apostkap/Arduina/photos/15.jpg

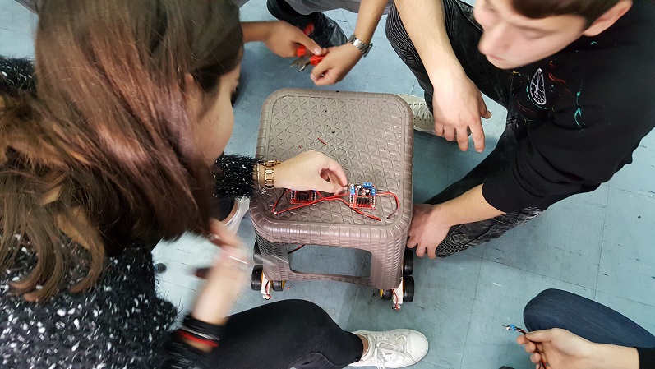
photos/15.jpg
