apostkap/Arduina/photos/26.jpg

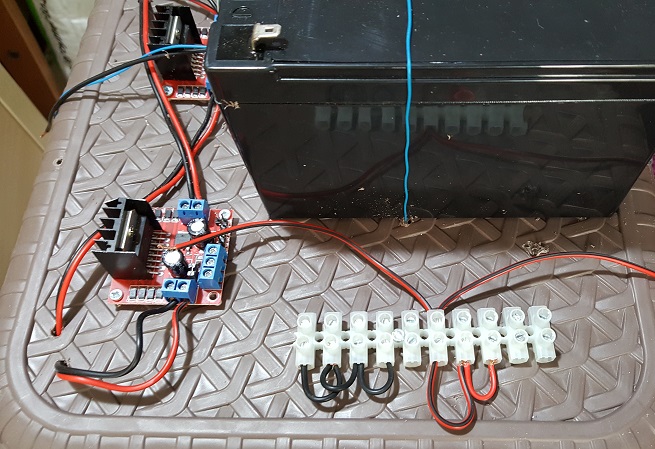
photos/26.jpg
