apostkap/Arduina/README.md

# Arduina- 1ο ΕΠΑΛ Ελευθερούπολης

Έργο για τον Διαγωνισμό Ρομποτικής

«Δεν θέλουμε να δούμε τον πλανήτη μας να μετασχηματίζεται σε μια απέραντη χωματερή. Επιδιώκουμε μείωση του όγκου των σκουπιδιών μας» 

«Επαναχρησιμοποίηση των πάντων, τις περισσότερες φορές μέσω μεταποίησης των αρχικών προϊόντων»

«Όταν η κίνηση οποιουδήποτε οχήματος είναι συνυφασμένη με καύση υδρογονανθράκων η κλιματική αλλαγή είναι αναπόφευκτη. Αλλάζουμε αντιλήψεις, τα οχήματα μας δεν εκπέμπουν καυσαέρια»

«Χρησιμοποιούμε ανοικτό κώδικα και ανοικτό hardware, πιστεύουμε στην επαναχρησιμοποίηση λογισμικού και υλικού, σε φθηνές λύσεις δηλαδή κατασκευής και προγραμματισμού εξαρτημάτων-συσκευών»

«Κατανοούμε τις συνέπειες της κλιματικής αλλαγής, μαθαίνουμε τις αιτίες δημιουργίας της και αλλάζουμε αντιλήψεις και πρακτικές»

Τις παραπάνω σκέψεις ενσωματώσαμε στην ιδέα μας για την κατασκευή του ανθρωπόμορφου ρομπότ μας. Θέλουμε να κατασκευάσουμε ένα σχετικά μεγάλο ρομπότ, μεγαλύτερο από τις συνηθισμένες διαστάσεις των οχημάτων που προγραμματίζονται με arduino. Επίσης ως προς την κατασκευή δεν θέλουμε να μείνουμε στο απλό κούμπωμα- βίδωμα συμβατικών εξαρτημάτων αλλά στον αυτοσχεδιασμό και στην εφευρετικότητα. Και το σημαντικότερο η κατασκευή μας θέλουμε να έχει χαμηλό κόστος και επαναχρησιμοποιούμενα υλικά.
Το κορμί της Arduina (το όνομα του ρομπότ μας) θα «χτιστεί» με δύο επαναχρησιμοποιούμενα σκαμπό ντυμένα με μακό T-shirt. Το κεφάλι θα κατασκευαστεί από σκληρό χαρτόνι (σχεδίαση με γεωμετρικά όργανα, κόψιμο με ψαλίδι και κόλλημα με κόλλες stick). Οι άξονες από ρόδες-κινητήρες θα στερεωθούν πάνω σε ηλεκτρολογικό κανάλι.
Το κεφάλι της  Arduina θα μπορεί να περιστρέφεται δεξιά και αριστερά όταν κάποιος το πλησιάζει. Στην θέση των ματιών θα υπάρχουν LCD οθόνες όπου θα εμφανίζονται διάφορα μηνύματα, σχήματα και Emoticons.
Η Arduina θα χρησιμοποιηθεί ως μεταφορέας πραγμάτων. Θα είναι τηλεκατευθυνόμενη μέσω κινητού τηλεφώνου. 
Ο στόχος μας δεν είναι να επικεντρωθούμε μόνο στην μεταφορική  ικανότητα της κατασκευής μας. Δεν θέλουμε να φτιάξουμε ένα τηλεκατευθυνόμενο καλάθι αλλά ένα ρομπότ που να θυμίζει τα ανθρωπόμορφα ρομπότ του cinema και της αγοράς παιχνιδιών. Η ρομποτική κατασκευή αφενός θα έχει χρηστική αξία (μεταφορέας αντικειμένων) αφετέρου θα είναι διασκεδαστική δίνοντας στους μαθητές κίνητρο και θέληση για εργασία. 
Οι μαθητές θα αποκτήσουν γνώσεις ρομποτικής και θα εκπαιδευτούν στην κυκλική οικονομία (δουλεύοντας με ανακυκλώσιμα υλικά, με φτηνά υλικά και ανοικτό hardware).   

ΝΕΑ ΕΠΙΚΑΙΡΟΠΟΙΗΜΕΝΗ ΛΙΣΤΑ ΥΛΙΚΩΝ ΚΑΙ ΚΟΣΤΟΣ:

1.	Arduino UNO (1 Τεμάχιο). Ένα arduino θα ελέγχει την  κίνηση του κεφαλιού και θα δημιουργεί σχήματα-μηνύματα στις δύο lcd οθόνες.Κόστος Arduino UNO R3 DIP (A000066) 1*22.25=22.25 €
2.	Γέφυρες L298Ν (2 Τεμάχια). Θα χρησιμοποιηθούν δύο γέφυρες για να μοιραστεί η παρεχόμενη ισχύς στους κινητήρες των ροδών. Η κάθε γέφυρα θα συνδέεται με δύο κινητήρες. Κόστος Stepper Driver Board Module L298N Dual H Bridge 2*5.1=10.2 €
3.	Κινητήρες με μειωτή στροφών και ρόδα (4 τεμάχια). Car Plastic Tire Wheel with DC 3-6v Gear Motor for Arduino 	4*3.5=14 €
4.	Πλακέτα WiFi. Κόστος NodeMCU board ESP8266 WiFi module ESP-12E Lua WiFi  1*6.99=6,99 €
5.	Αισθητήρες απόστασης (2 τεμάχια). Κόστος 	HY-SRF05 Ultrasonic Distance Sensor Module Replace SR04 Module 	2*2.49=4.98 €
6. Βάσεις για τους αισθητήρες απόστασης (2 τεμάχια). Κόστος Acrylic Ultrasonic Sensor Mounting Bracket for HC-SR04 Module	2*0.69=1.38 €
7.	Σερβοκινητήρας. Θα χρησιμοποιηθεί για την κίνηση του κεφαλιού. Κόστος JX PS-5521MG 20KG Large Torque Metal Gear Standrd Analog Servo For RC Robot	1*27.28=27.28 €
8.	Οθόνες LCD (2 τεμάχια). Κόστος 1602A blue display	2*3.47=6.94 €
9.	Μεταβλητός αντιστάτης (1 τεμάχιο). Θα χρησιμοποιηθεί για τον έλεγχο φωτεινότητας των οθονών. Κόστος Panel Mount 10K Dual Log Potentiometer - 10K Dual Log  1*3.47=3.47 €
10. Καπάκι για τον μεταβλητό αντιστάτη. Κόστος Potentiometer Control Rotary Knobs Red  1*0.37=0.37 €
11.	Μπαταρία 12V . Για την κίνηση του ρομπότ. Κόστος megaBAT MB 9-12 Μπαταρία 12V 9Ah 151Χ65Χ95mm  		1*20=20 €
12.	Διακόπτης ON-OFF (2 τεμάχια). Κόστος MTS-102 3-Pin SPDT ON-OFF-ON 6A Mini Toggle Switch 		2*0,6=1,2 €
13. Συνδετήρας καλωδίων. Κόστος SET Pair 2.1x5.5mm Male & Female Barrel DC Power Jack Connector 1*0.74=0.74 €
14. Βreadboard. Κόστος 270 holes breadboard 1*1.98=1.98 €
15. Βreadboard (2 τεμάχια). Κόστος White Solderless Prototype Breadboard 170 Tie-points for Arduino 2*1,30=2.6 €
16.	Καλώδια. Κόστος	40pcs Small Male to Female Dupont Wires/Cables for Arduino (10cm) (M/F) 1*2.99 =2.99 €
17. Καλώδια. Κόστος 40Pcs M/F Dupont Wire Jumper Cables 1*3.5=3.5 €
18. Καλώδια. Κόστος 40Pcs M/F Dupont Wire Jumper Cables 40 cm  1*4.96=4.96 €
19. Ηλεκτρολογικό κανάλι
20.	Χαρτόνι. 
21.	Κόλλα.
22.	Βίδες. 
23.	Σκαμπό (2 τεμάχια επαναχρησιμοποιούμενα). Για το σκελετό του ρομπότ. 
24.	T-shirt (επαναχρησιμοποιούμενο).

ΣΥΝΟΛΙΚΟ ΚΟΣΤΟΣ ΥΛΙΚΩΝ (Εκτίμηση)		135.83 €
