apostkap/Arduina/Σελίδα στο ΕΛΛΑΚ.md

[Σελιδα στο ΕΛΛΑΚ](https://openedtech.ellak.gr/robotics2020/eco-robotics-1o-epal-eleftheroupolis-arduina/)
