apostkap/Arduina/Βίντεο_ στο_youtube.md

[H Arduina στο youtube](https://www.youtube.com/watch?v=q3HY2vY7Ny0)
