apostkap/Arduina/Πορεία_κατασκευής.pdf

### Arduina - Πορεία κατασκευής

1. Τοποθέτηση ηλεκτρολογικού καναλιού στο κάτω μέρος του σκαμπό. Στερέωση με ξυλόβιδες

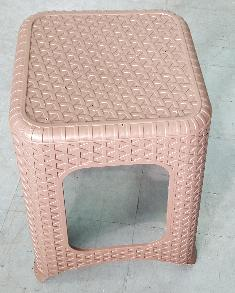
[picture p3: figure]
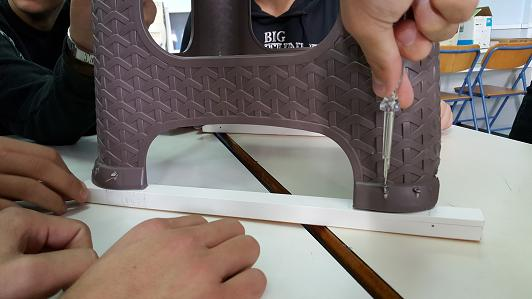
[picture p4: figure]

2. Κόλληση αγωγών στους ακροδέκτες των τεσσάρων κινητήρων.

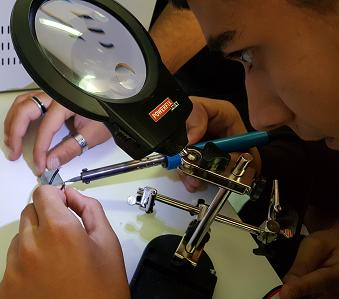
[picture p5: figure]

3. Στερέωση των τεσσάρων κινητήρων στα ηλεκτρολογικά κανάλια.

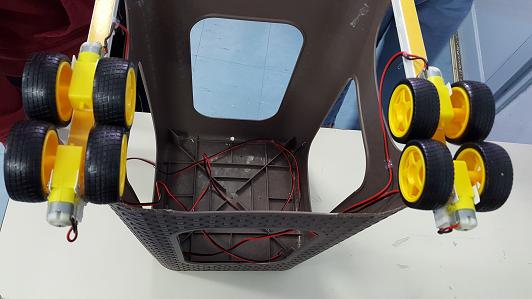
[picture p6: figure]
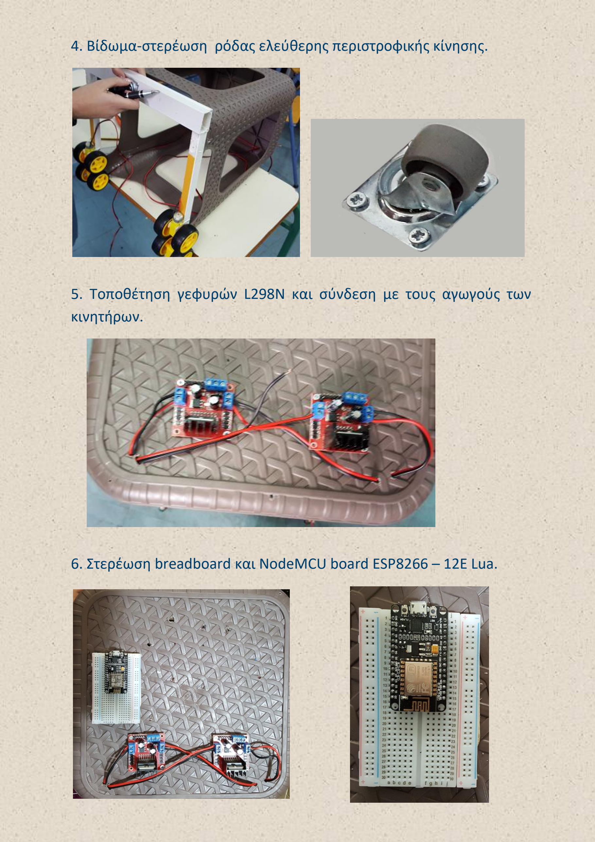
[picture p7: page 2]

4. Βίδωμα-στερέωση ρόδας ελεύθερης περιστροφικής κίνησης.
5. Τοποθέτηση γεφυρών L298N και σύνδεση με τους αγωγούς των κινητήρων.
6. Στερέωση breadboard και NodeMCU board ESP8266 – 12E Lua.

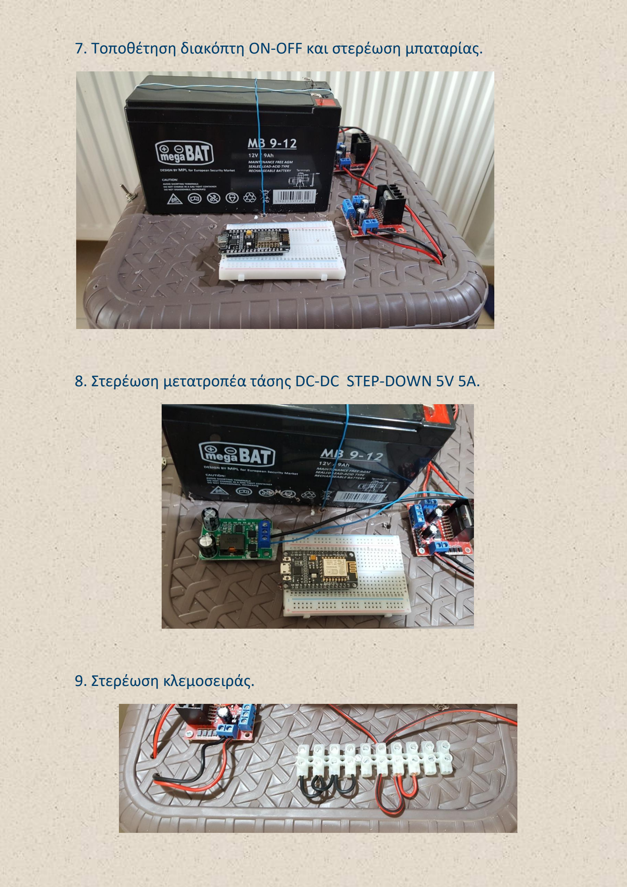
[picture p8: page 3]

7. Τοποθέτηση διακόπτη ON-OFF και στερέωση μπαταρίας.
8. Στερέωση μετατροπέα τάσης DC-DC STEP-DOWN 5V 5A.
9. Στερέωση κλεμοσειράς.

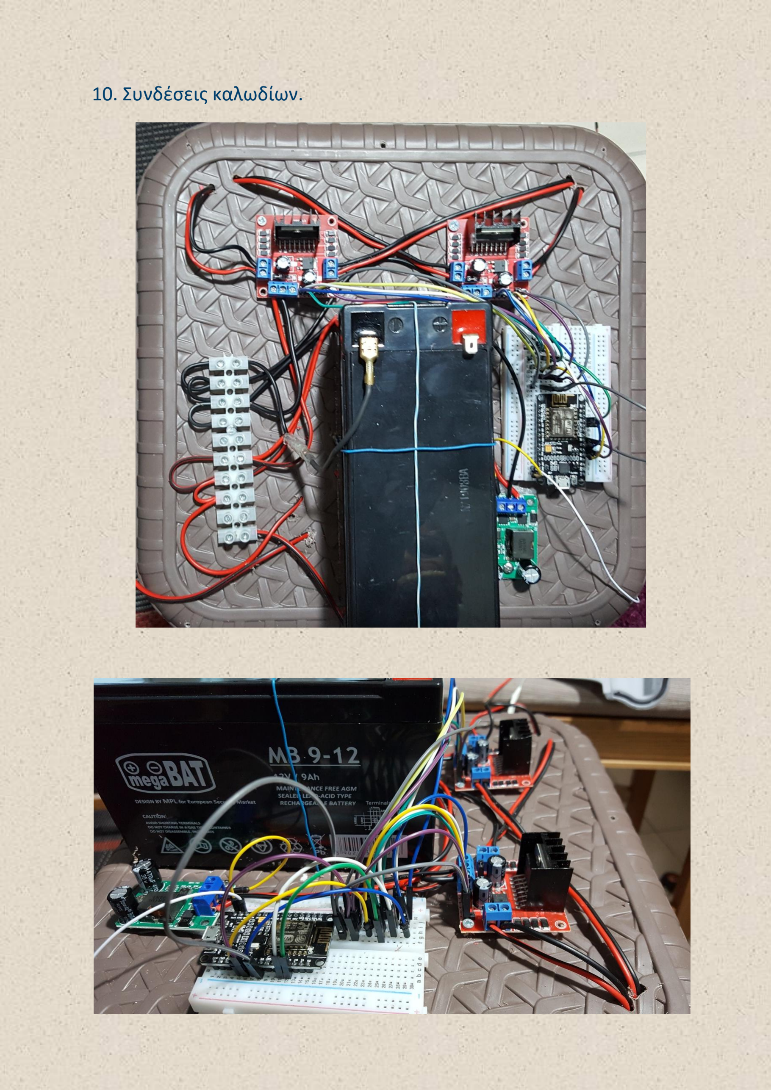
[picture p9: page 4]

10. Συνδέσεις καλωδίων.

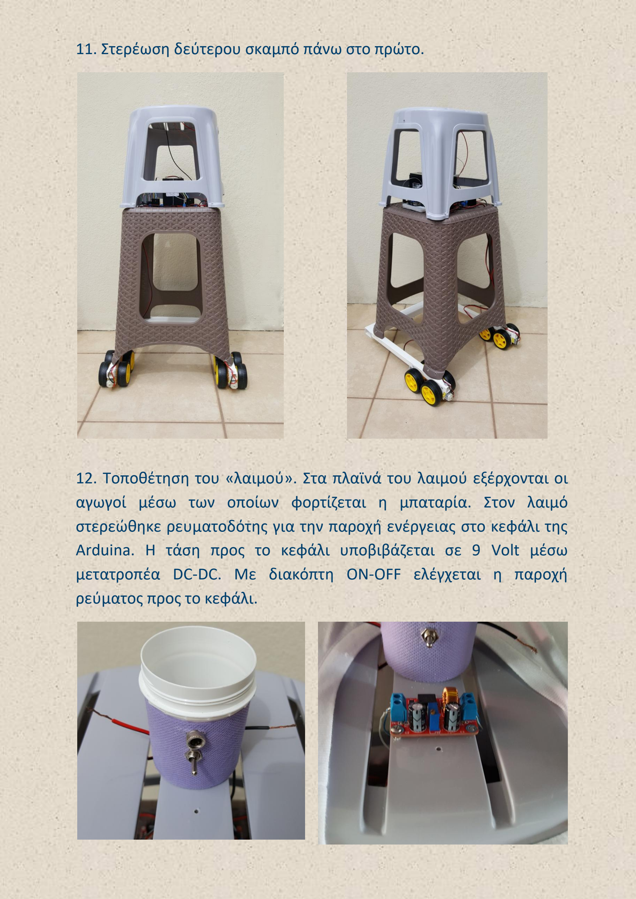
[picture p10: page 5]

11. Στερέωση δεύτερου σκαμπό πάνω στο πρώτο.
12. Τοποθέτηση του «λαιμού». Στα πλαϊνά του λαιμού εξέρχονται οι αγωγοί μέσω των οποίων φορτίζεται η μπαταρία. Στον λαιμό στερεώθηκε ρευματοδότης για την παροχή ενέργειας στο κεφάλι της Arduina. Η τάση προς το κεφάλι υποβιβάζεται σε 9 Volt μέσω μετατροπέα DC-DC. Με διακόπτη ON-OFF ελέγχεται η παροχή ρεύματος προς το κεφάλι.

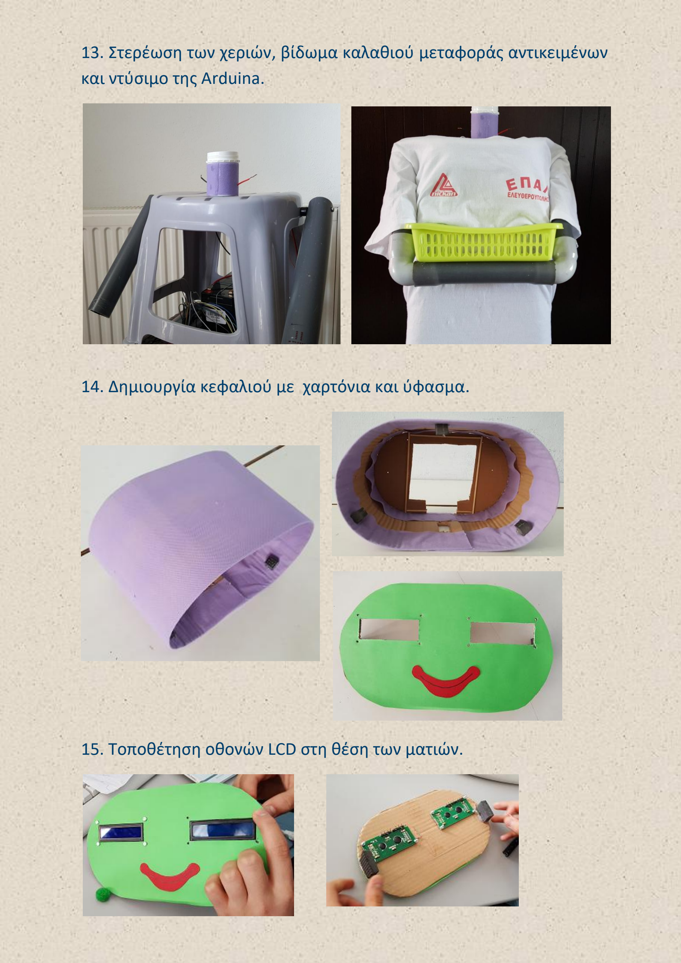
[picture p11: page 6]

13. Στερέωση των χεριών, βίδωμα καλαθιού μεταφοράς αντικειμένων και ντύσιμο της Arduina.
14. Δημιουργία κεφαλιού με χαρτόνια και ύφασμα.
15. Τοποθέτηση οθονών LCD στη θέση των ματιών.

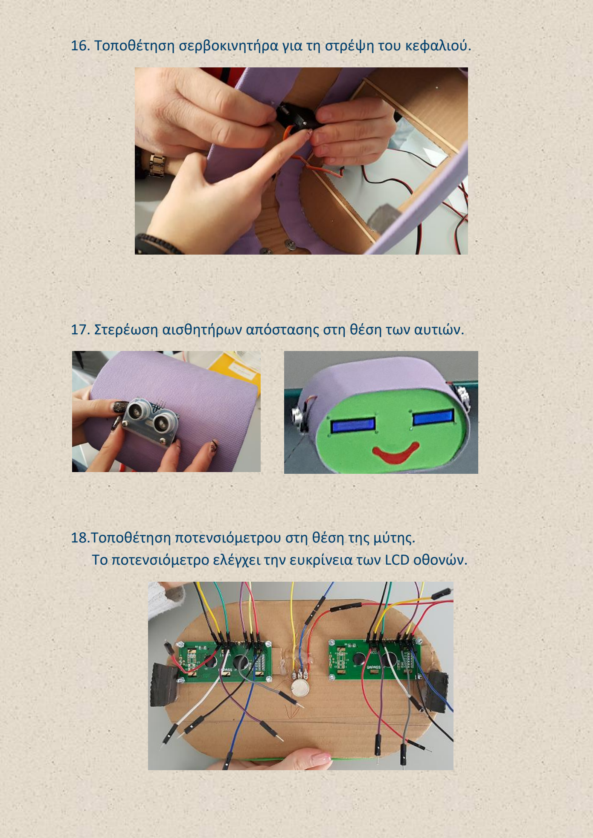
[picture p12: page 7]

16. Τοποθέτηση σερβοκινητήρα για τη στρέψη του κεφαλιού.
17. Στερέωση αισθητήρων απόστασης στη θέση των αυτιών.

18.Τοποθέτηση ποτενσιόμετρου στη θέση της μύτης.
Το ποτενσιόμετρο ελέγχει την ευκρίνεια των LCD οθονών.

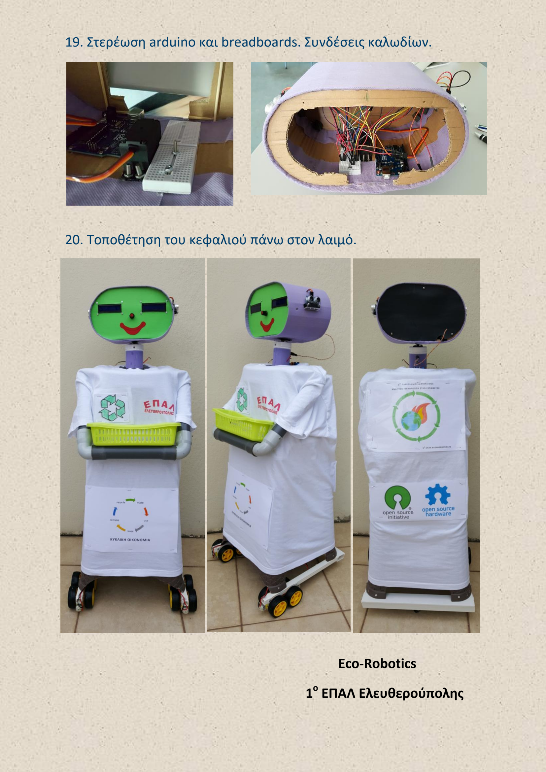
[picture p13: page 8]

19. Στερέωση arduino και breadboards. Συνδέσεις καλωδίων.
20. Τοποθέτηση του κεφαλιού πάνω στον λαιμό.

Eco-Robotics

1

ο
ΕΠΑΛ Ελευθερούπολης
