apostkap/Arduina/photos/13.jpg

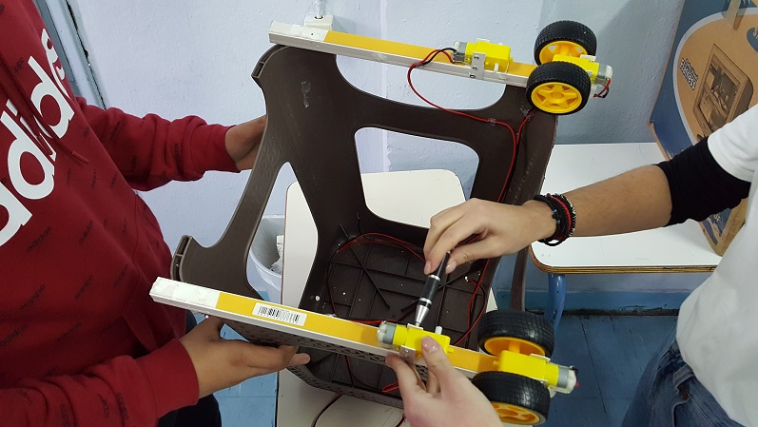
photos/13.jpg
