apostkap/Arduina/photos/14.jpg

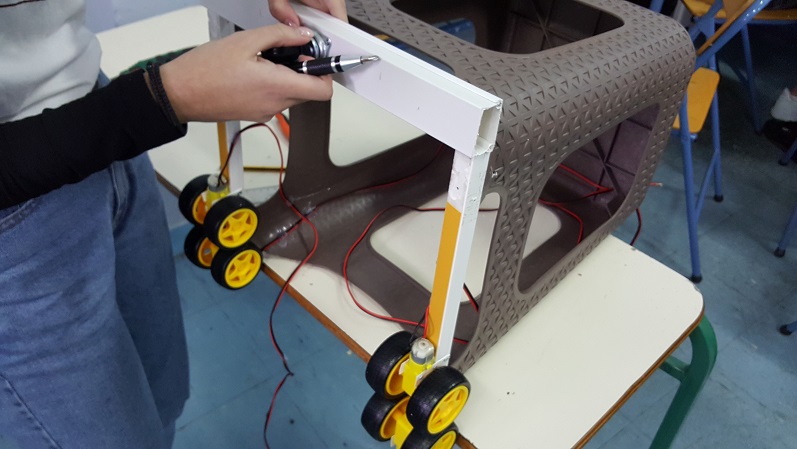
photos/14.jpg
