apostkap/Arduina/photos/16.jpg

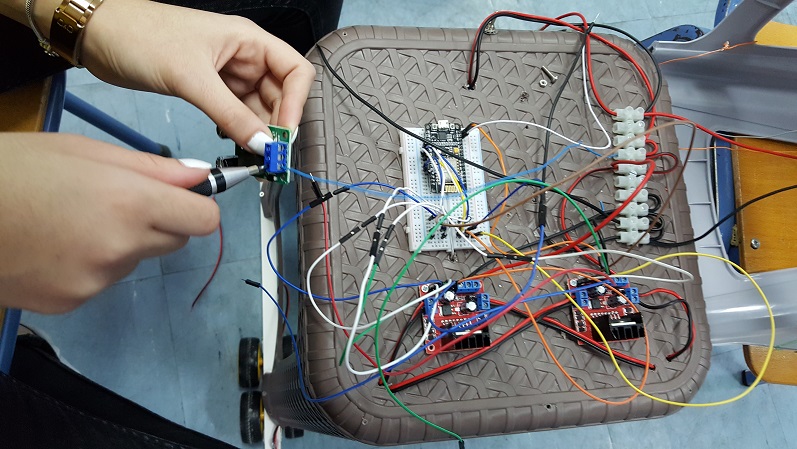
photos/16.jpg
