apostkap/Arduina/photos/17.jpg

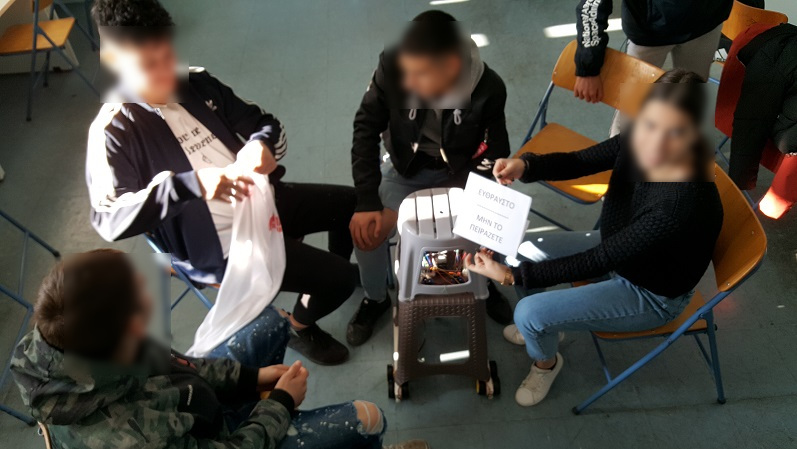
photos/17.jpg
