apostkap/Arduina/photos/18.jpg

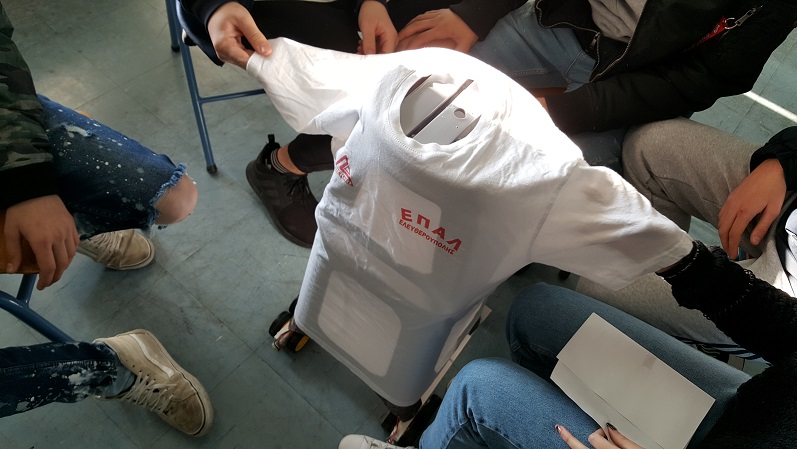
photos/18.jpg
