apostkap/Arduina/photos/19.jpg

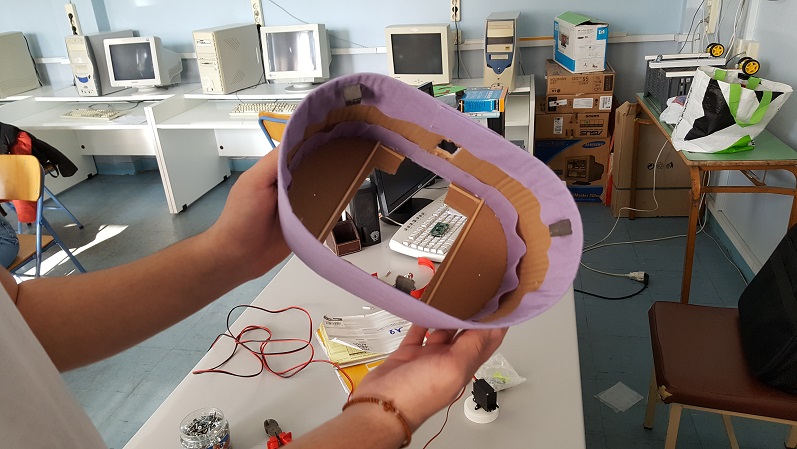
photos/19.jpg
