apostkap/Arduina/photos/20.jpg

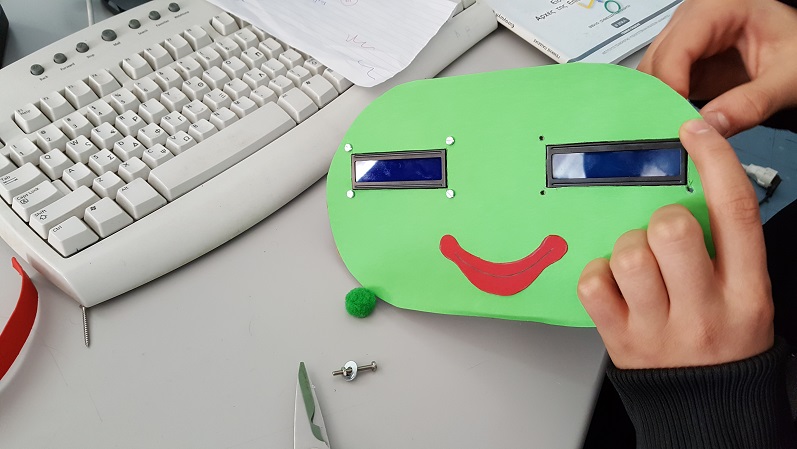
photos/20.jpg
