apostkap/Arduina/photos/21.jpg

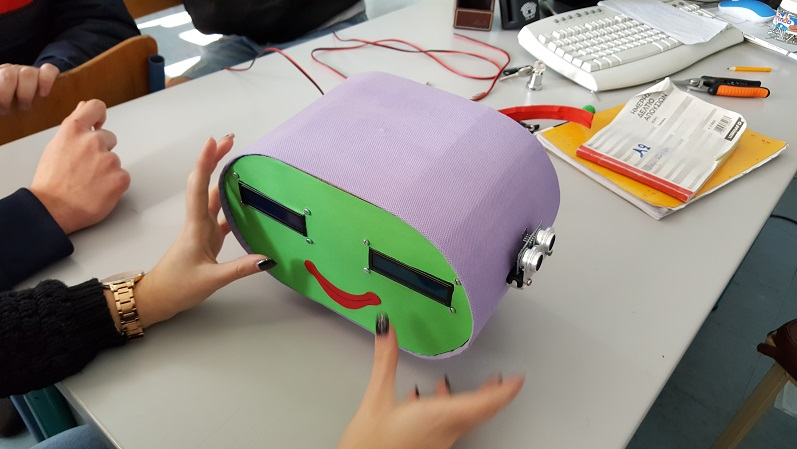
photos/21.jpg
