apostkap/Arduina/photos/22.jpg

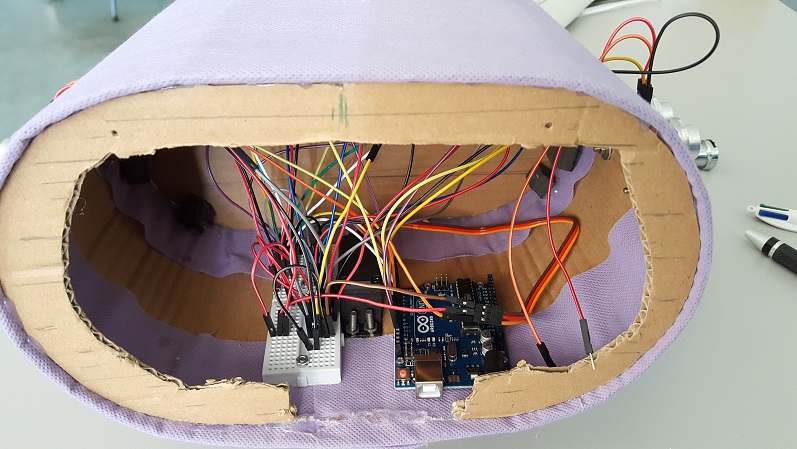
photos/22.jpg
