apostkap/Arduina/photos/23.jpg

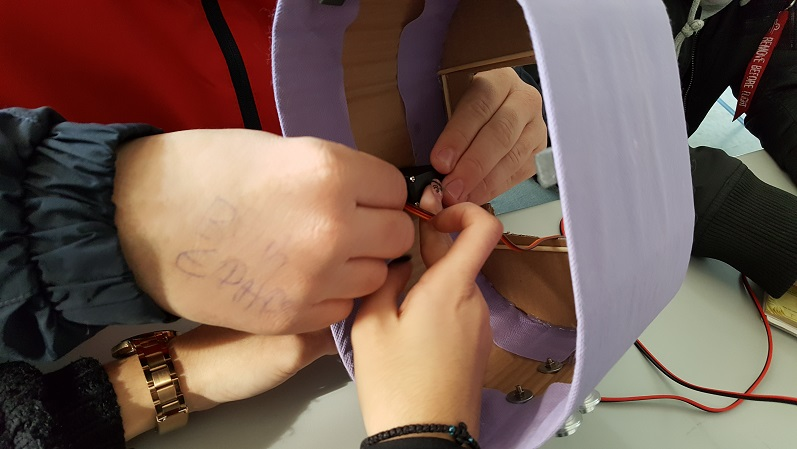
photos/23.jpg
