apostkap/Arduina/photos/24.jpg

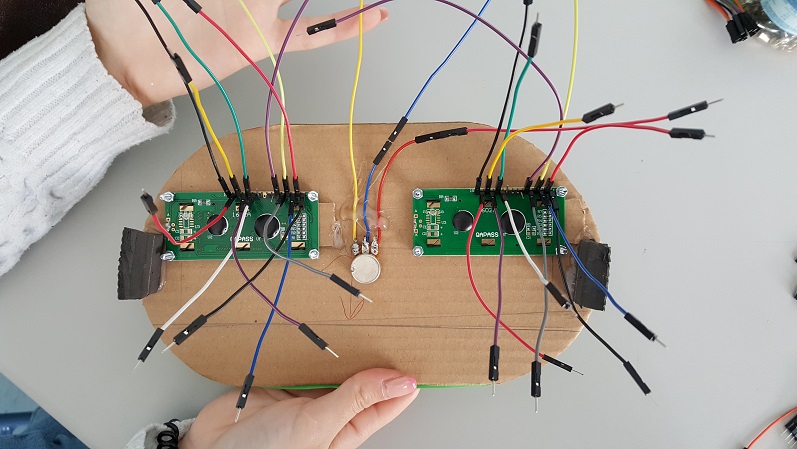
photos/24.jpg
