apostkap/Arduina/photos/25.jpg

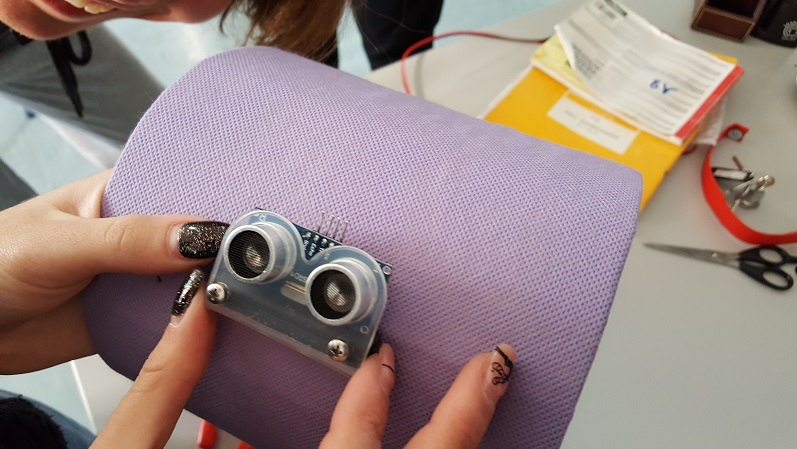
photos/25.jpg
