apostkap/Arduina/photos/27.jpg

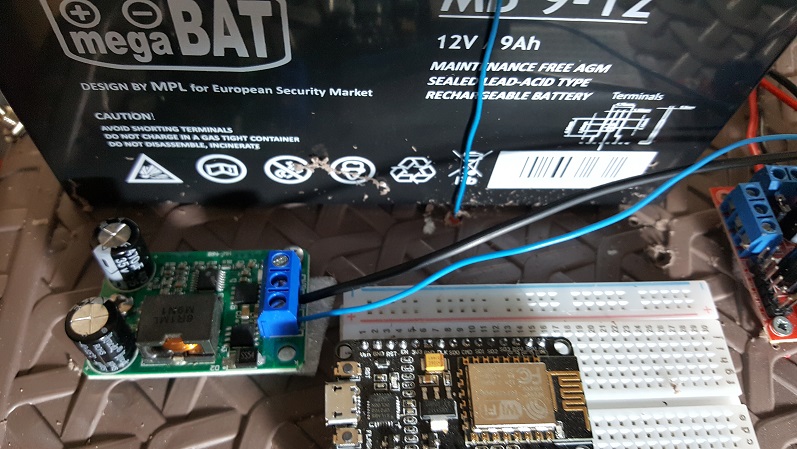
photos/27.jpg
