apostkap/Arduina/photos/28.jpg

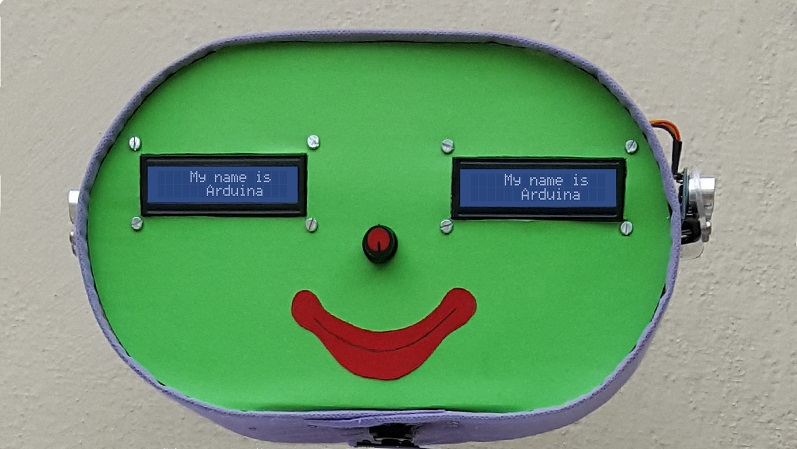
photos/28.jpg
