apostkap/Arduina/photos/29.jpg

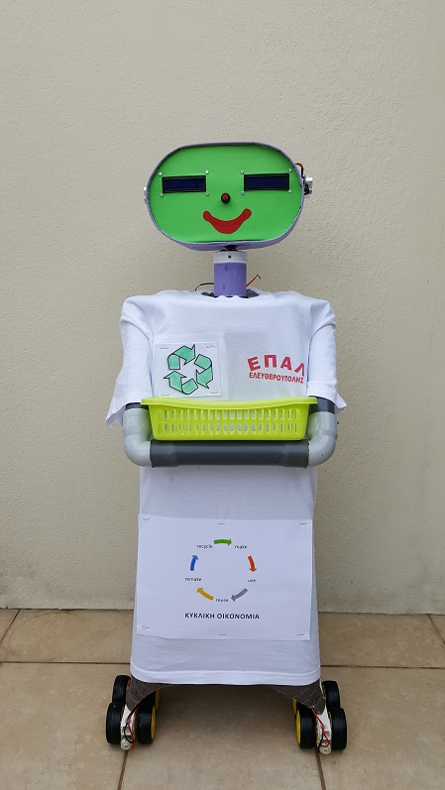
photos/29.jpg
