apostkap/Arduina/photos/30.jpg

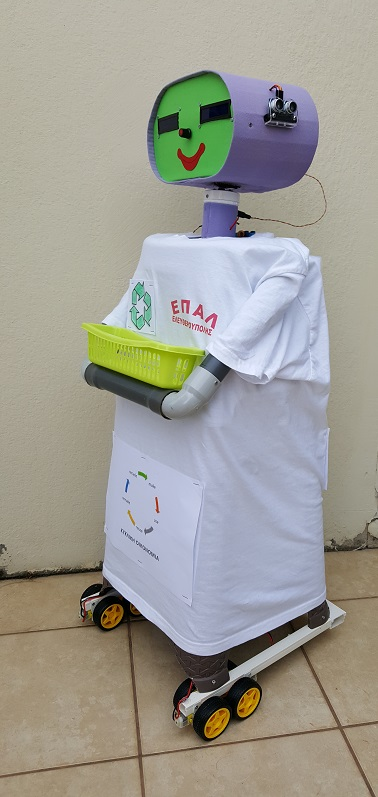
photos/30.jpg
