apostkap/Arduina/wiring_ diagram_head.pdf

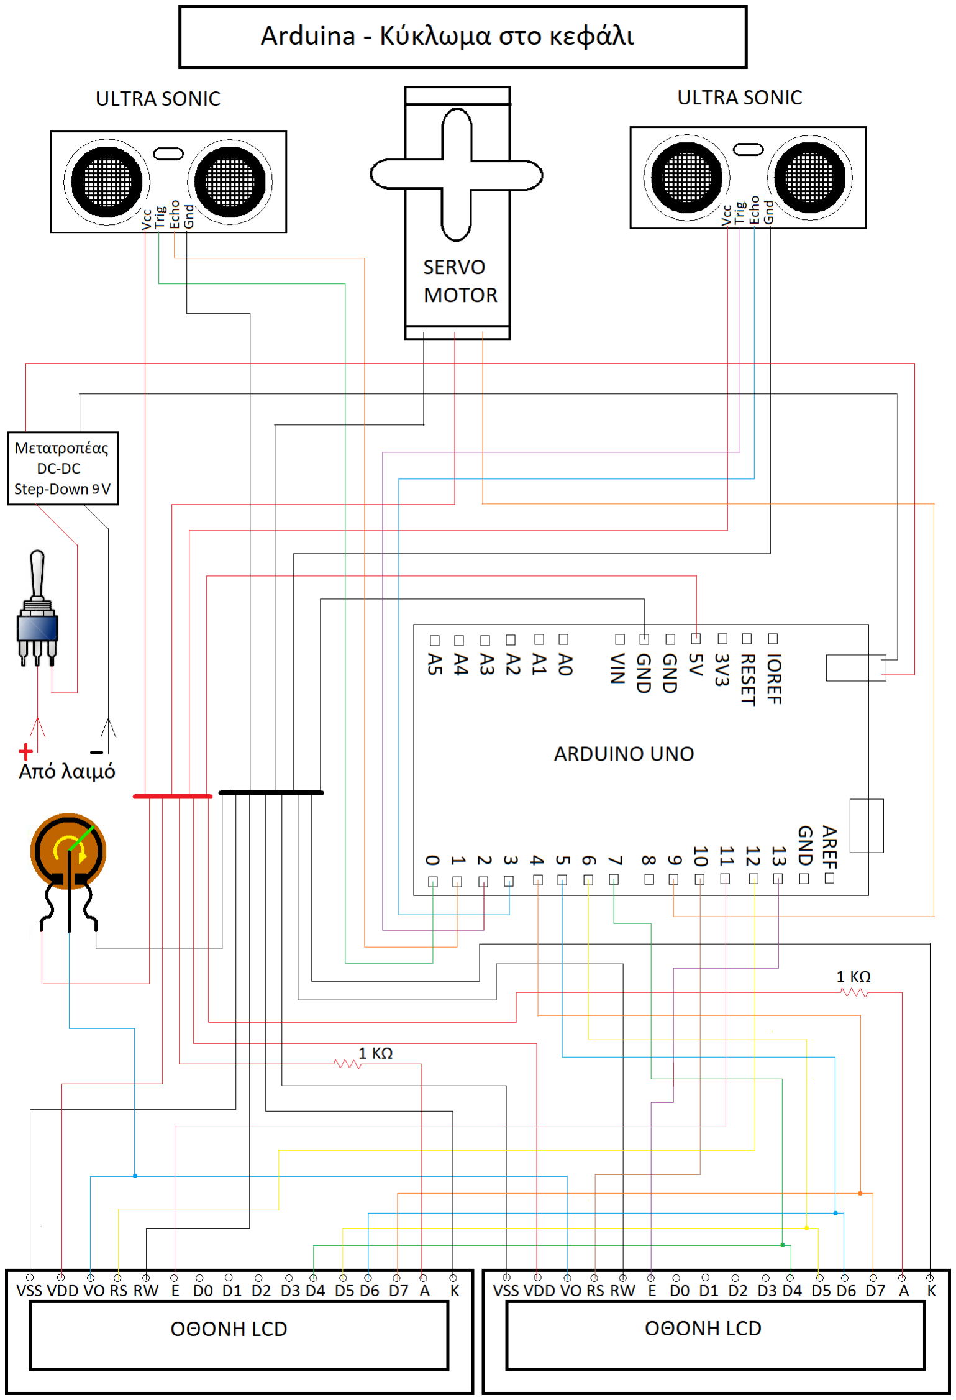
[picture p30: page 1]
