apostkap/Arduina/wiring_diagram_body.pdf

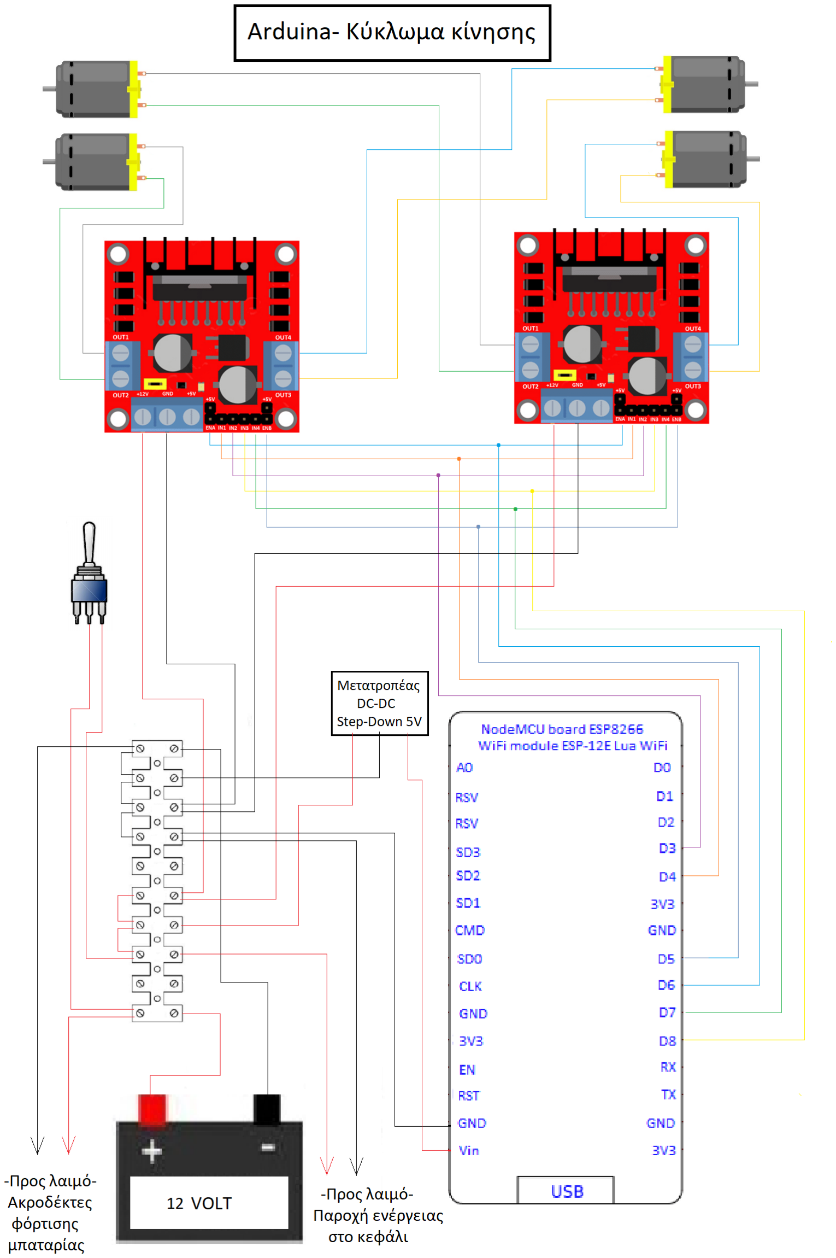
[picture p31: page 1]
