apostkap/Arduina/(commit log)

2020-04-16 upload wiring diagram (body)
2020-04-16 upload wiriing diagram (head)
2020-05-16 Create Arduina_Body.ino
    Πρόγραμμα κίνησης στο NodeMCU board ESP8266 WiFi module ESP-12E Lua WiFi
2020-05-16 App Inventor
    Δημιουργία της εφαρμογής Κίνησης της Arduina στο App Inventor
2020-05-19 Update wiring_ diagram_head.pdf
2020-05-28 Create youtube.html
    Η Arduina στο youtube
2020-05-28 Create youtube.md
    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
2020-05-28 Η Arduina στο youtube
2020-05-28 Σελίδα στο ΕΛΛΑΚ
